Galacs/valrob-carte-actionneurs-cdf-1/valrob-carte-actionneurs-cdf-1.kicad_pcb

## KiCad design valrob-carte-actionneurs-cdf-1.kicad_pcb (2026-04-12)

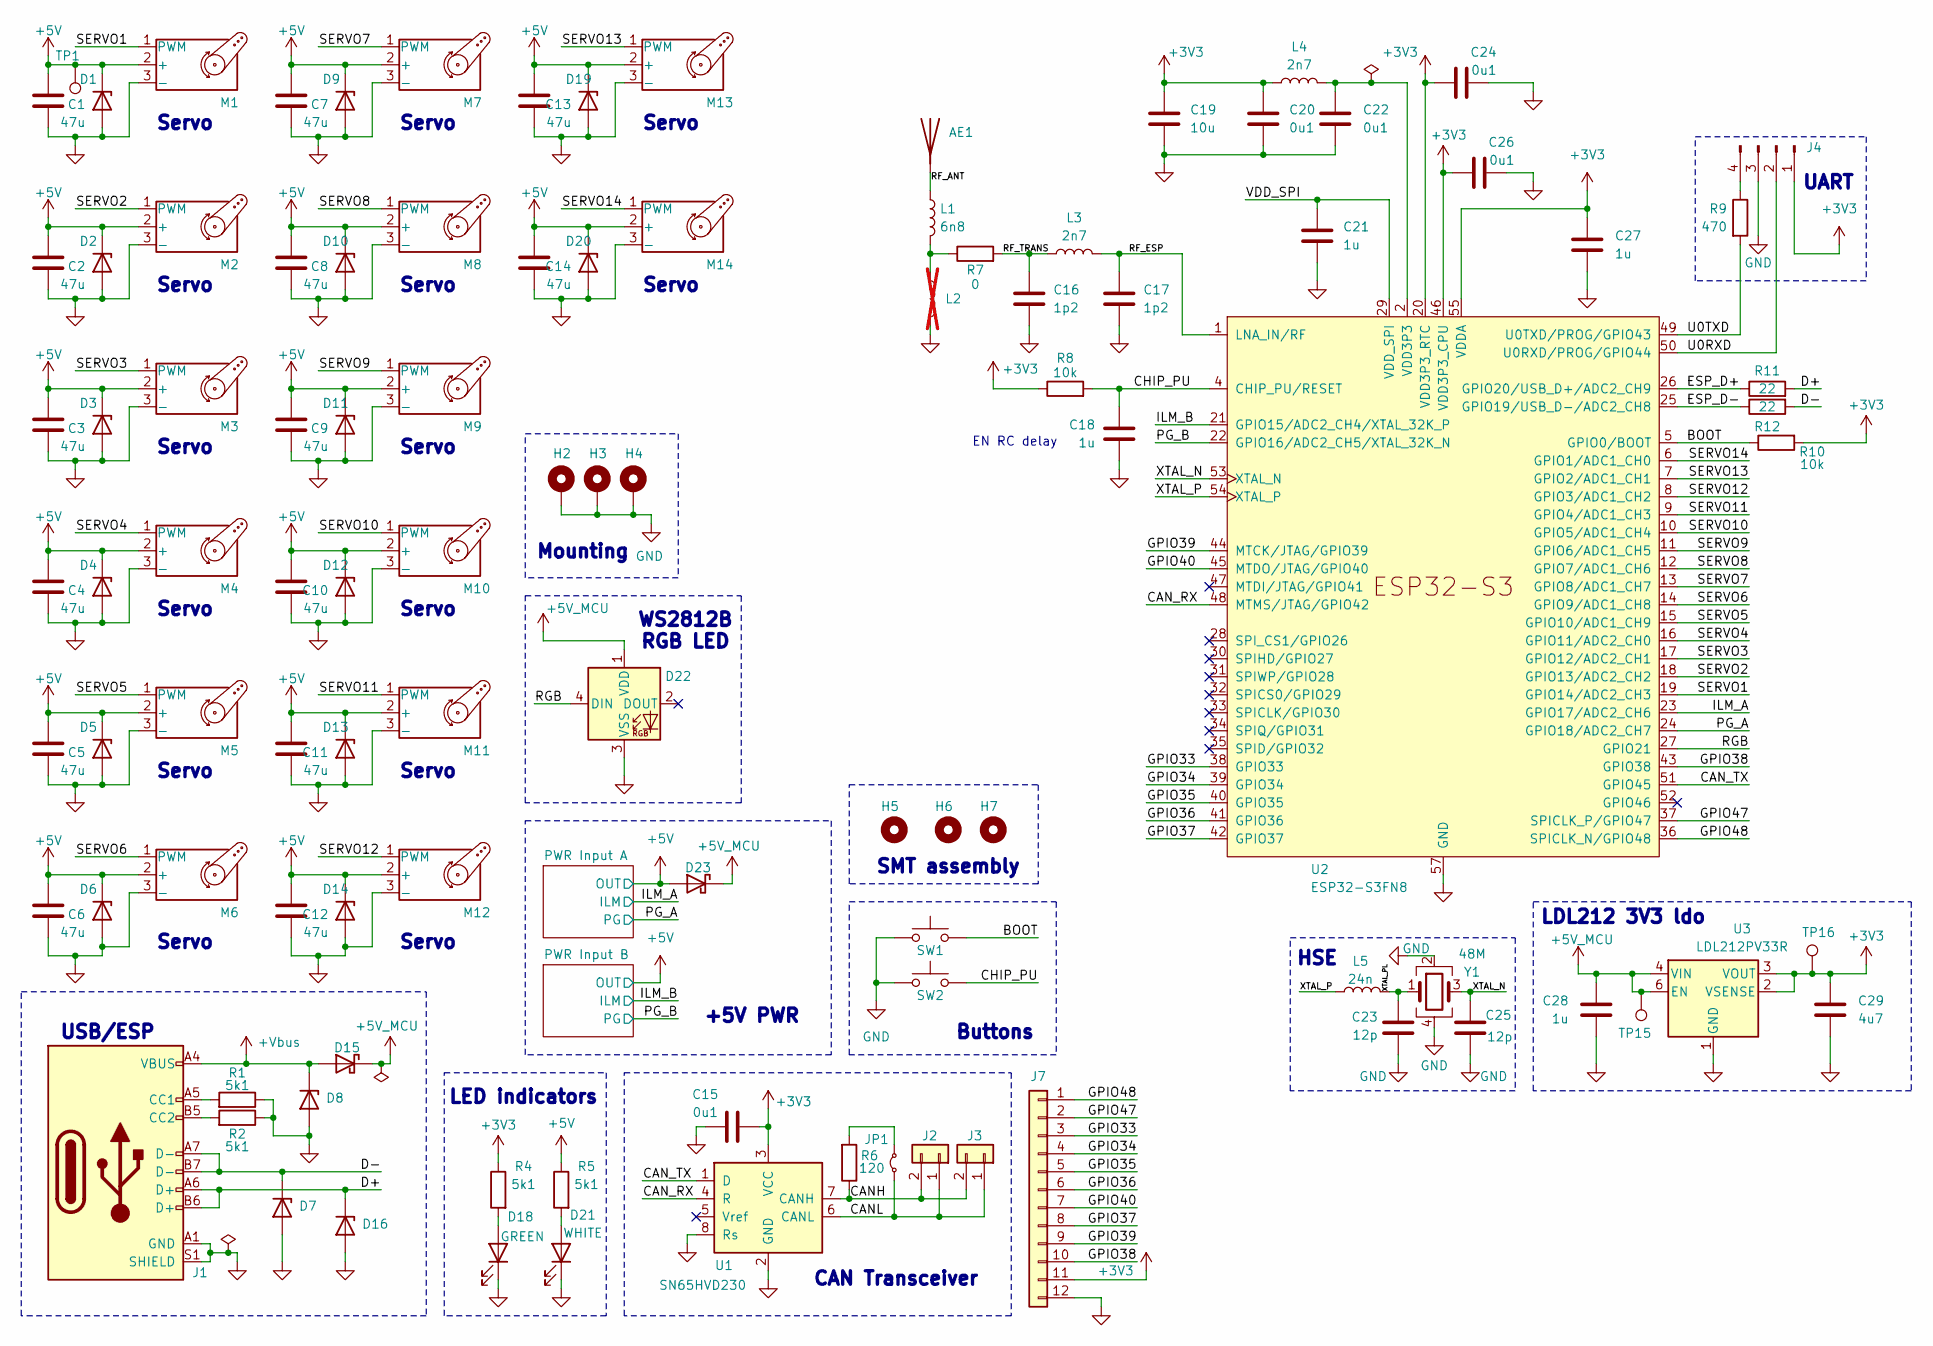
[picture p1: schematic valrob-carte-actionneurs-cdf-1.kicad_sch, Carte actionneurs CDF 1]

Parts:
AE1: Antenna; Johanson_2450AT18x100; Manufacturer Part Number RFANT3216120A5T; JLCPCB Part # C127629
C1, C2, C3, C4, C5, C6, C7, C8, C9, C10, C11, C12, C13, C14: 47u; C_1206_3216Metric; Manufacturer Part Number CL31A476MPHNNNE; JLCPCB Part # C96123
C15, C20, C22, C24, C26: 0u1; C_0402_1005Metric; Manufacturer Part Number CL05B104KB54PNC; JLCPCB Part # C307331
C16, C17: 1p2; C_0402_1005Metric; Manufacturer Part Number GJM1555C1H1R2WB01D; JLCPCB Part # C76899
C18, C21, C27, C28: 1u; C_0402_1005Metric; Manufacturer Part Number CL05A105KA5NQNC; JLCPCB Part # C52923
C19: 10u; C_0402_1005Metric; Manufacturer Part Number CL05A106MQ5NUNC; JLCPCB Part # C15525
C23, C25: 12p; C_0402_1005Metric; Manufacturer Part Number 0402CG120J500NT; JLCPCB Part # C1547
C29: 4u7; C_0402_1005Metric; Manufacturer Part Number CL05A475MP5NRNC; JLCPCB Part # C23733
D1, D2, D3, D4, D5, D6, D7, D8, D9, D10, D11, D12, D13, D14, D16, D19, D20: H5VU10U; Diode_DFN1006; Manufacturer Part Number H5VU10U; JLCPCB Part # C22395519
D15, D23: D_Schottky; D_SMA; Manufacturer Part Number SS54; JLCPCB Part # C22452
D18: GREEN; LED_0805_2012Metric; Manufacturer Part Number KT-0805G; JLCPCB Part # C2297
D21: WHITE; LED_0603_1608Metric; Manufacturer Part Number KT-0603W; JLCPCB Part # C2290
D22: WS2812B; LED_WS2812B_PLCC4_5.0x5.0mm_P3.2mm; Manufacturer Part Number WS2812B-V5/W; JLCPCB Part # C2874885
H2, H3, H4: MountingHole_Pad; MountingHole_2.2mm_M2_Pad_Via
H5, H6, H7: MountingHole; ToolingHole_1.152mm
J1: USB_C_Receptacle_USB2.0_14P; USB_C_Receptacle_HRO_TYPE-C-31-M-12; Manufacturer Part Number TYPE-C16PIN; JLCPCB Part # C393939
J2, J3: Conn_01x02; JST_XH_B2B-XH-A_1x02_P2.50mm_Vertical; Manufacturer Part Number B2B-XH-A(LF)(SN); JLCPCB Part # C158012
J4: Conn_01x04_Pin; PinHeader_1x04_P2.54mm_Vertical
J7: Conn_01x12; PinHeader_2x06_P2.54mm_Vertical
JP1: Jumper_2_Small_Bridged; SolderJumper-2_P1.3mm_Open_RoundedPad1.0x1.5mm
L1: 6n8; L_0402_1005Metric; Manufacturer Part Number LQG15HS6N8J02D; JLCPCB Part # C77110
L2: L; L_0402_1005Metric; not fitted
L3, L4: 2n7; L_0402_1005Metric; Manufacturer Part Number LQG15HS2N7S02D; JLCPCB Part # C77108
L5: 24n; L_0402_1005Metric; Manufacturer Part Number LQW15AN24NG00D; JLCPCB Part # C167472
M1, M2, M3, M4, M5, M6, M7, M8, M9, M10, M11, M12, M13, M14: Motor_Servo; PinHeader_1x03_P2.54mm_Vertical
R1, R2, R4, R5: 5k1; R_0402_1005Metric; Manufacturer Part Number 0402WGF5101TCE; JLCPCB Part # C25905
R6: 120; R_1206_3216Metric; Manufacturer Part Number 1206W4F1200T5E; JLCPCB Part # C17909
R7: 0; R_0402_1005Metric; Manufacturer Part Number 0402WGF0000TCE; JLCPCB Part # C17168
R8, R10: 10k; R_0402_1005Metric; Manufacturer Part Number 0402WGF1002TCE; JLCPCB Part # C25744
R9: 470; R_0402_1005Metric; Manufacturer Part Number 0402WGF4700TCE; JLCPCB Part # C25117
R11, R12: 22; R_0402_1005Metric; Manufacturer Part Number 0402WGF220JTCE; JLCPCB Part # C25092
SW1, SW2: SW_Push; SW_SPST_TS-1088-xR020; Manufacturer Part Number TS-1088-AR02016; JLCPCB Part # C720477
TP1, TP15, TP16: TestPoint; TestPoint_Pad_D2.0mm
U1: SN65HVD230; SOIC-8_3.9x4.9mm_P1.27mm; Manufacturer Part Number SN65HVD230DR; JLCPCB Part # C12084
U2: ESP32-S3FN8; QFN-56-1EP_7x7mm_P0.4mm_EP4x4mm_ThermalVias; Manufacturer Part Number ESP32-S3FH4R2; JLCPCB Part # C3013940
U3: LDL212PV33R; DFN-6-1EP_2x2mm_P0.5mm_ST; Manufacturer Part Number LDL212PV33R; JLCPCB Part # C2969892
Y1: 48M; Crystal_SMD_2016-4Pin_2.0x1.6mm; Manufacturer Part Number R940000096; JLCPCB Part # C7206306

Connections:
+3V3: C15.1, C19.1, C20.1, C24.1, C26.1, C27.1, C29.1, J4.1, J7.11, L4.1, R4.1, R8.1, R10.2, TP16.1 (1_1), U1.3 (VCC), U2.20 (VDD3P3_RTC), U2.46 (VDD3P3_CPU), U2.55 (VDDA), U2.56 (VDDA), U3.2 (VSENSE), U3.3 (VOUT); also elsewhere on the board
+5V: C1.1, C2.1, C3.1, C4.1, C5.1, C6.1, C7.1, C8.1, C9.1, C10.1, C11.1, C12.1, C13.1, C14.1, D1.1 (K), D2.1 (K), D3.1 (K), D4.1 (K), D5.1 (K), D6.1 (K), D9.1 (K), D10.1 (K), D11.1 (K), D12.1 (K), D13.1 (K), D14.1 (K), D19.1 (K), D20.1 (K), D23.2 (A), M1.2 (+), M2.2 (+), M3.2 (+), M4.2 (+), M5.2 (+), M6.2 (+), M7.2 (+), M8.2 (+), M9.2 (+), M10.2 (+), M11.2 (+), M12.2 (+), M13.2 (+), M14.2 (+), R5.1, TP1.1 (1_1); also elsewhere on the board
+5V_MCU: C28.1, D15.1 (K), D22.1 (VDD), D23.1 (K), TP15.1 (1_1), U3.4 (VIN), U3.6 (EN)
+Vbus: D8.1 (K), D15.2 (A), J1.A4 (VBUS), J1.A9 (VBUS), J1.B4 (VBUS), J1.B9 (VBUS)
/BOOT: R10.1, SW1.2, U2.5 (GPIO0/BOOT)
/CANH: J2.2, J3.2, R6.1, U1.7 (CANH)
/CANL: J2.1, J3.1, JP1.1 (A), U1.6 (CANL)
/CAN_RX: U1.4 (R), U2.48 (MTMS/JTAG/GPIO42)
/CAN_TX: U1.1 (D), U2.51 (GPIO45)
/CHIP_PU: C18.1, R8.2, SW2.2, U2.4 (CHIP_PU/RESET)
/D+: D16.1 (K), J1.A6 (D+), J1.B6 (D+), R11.2
/D-: D7.1 (K), J1.A7 (D-), J1.B7 (D-), R12.2
/ESP_D+: R11.1, U2.26 (GPIO20/USB_D+/ADC2_CH9)
/ESP_D-: R12.1, U2.25 (GPIO19/USB_D-/ADC2_CH8)
/GPIO33: J7.3, U2.38 (GPIO33)
/GPIO34: J7.4, U2.39 (GPIO34)
/GPIO35: J7.5, U2.40 (GPIO35)
/GPIO36: J7.6, U2.41 (GPIO36)
/GPIO37: J7.8, U2.42 (GPIO37)
/GPIO38: J7.10, U2.43 (GPIO38)
/GPIO39: J7.9, U2.44 (MTCK/JTAG/GPIO39)
/GPIO40: J7.7, U2.45 (MTDO/JTAG/GPIO40)
/GPIO47: J7.2, U2.37 (SPICLK_P/GPIO47)
/GPIO48: J7.1, U2.36 (SPICLK_N/GPIO48)
/ILM_A: U2.23 (GPIO17/ADC2_CH6); also elsewhere on the board
/ILM_B: U2.21 (GPIO15/ADC2_CH4/XTAL_32K_P); also elsewhere on the board
/PG_A: U2.24 (GPIO18/ADC2_CH7); also elsewhere on the board
/PG_B: U2.22 (GPIO16/ADC2_CH5/XTAL_32K_N); also elsewhere on the board
/RF_ANT: AE1.1 (A_1), L1.1
/RF_ESP: C17.1, L3.2, U2.1 (LNA_IN/RF)
/RF_TRANS: C16.1, L3.1, R7.2
/RGB: D22.4 (DIN), U2.27 (GPIO21)
/SERVO1: M1.1 (PWM), U2.19 (GPIO14/ADC2_CH3)
/SERVO2: M2.1 (PWM), U2.18 (GPIO13/ADC2_CH2)
/SERVO3: M3.1 (PWM), U2.17 (GPIO12/ADC2_CH1)
/SERVO4: M4.1 (PWM), U2.16 (GPIO11/ADC2_CH0)
/SERVO5: M5.1 (PWM), U2.15 (GPIO10/ADC1_CH9)
/SERVO6: M6.1 (PWM), U2.14 (GPIO9/ADC1_CH8)
/SERVO7: M7.1 (PWM), U2.13 (GPIO8/ADC1_CH7)
/SERVO8: M8.1 (PWM), U2.12 (GPIO7/ADC1_CH6)
/SERVO9: M9.1 (PWM), U2.11 (GPIO6/ADC1_CH5)
/SERVO10: M10.1 (PWM), U2.10 (GPIO5/ADC1_CH4)
/SERVO11: M11.1 (PWM), U2.9 (GPIO4/ADC1_CH3)
/SERVO12: M12.1 (PWM), U2.8 (GPIO3/ADC1_CH2)
/SERVO13: M13.1 (PWM), U2.7 (GPIO2/ADC1_CH1)
/SERVO14: M14.1 (PWM), U2.6 (GPIO1/ADC1_CH0)
/U0RXD: J4.2, U2.50 (U0RXD/PROG/GPIO44)
/U0TXD: R9.2, U2.49 (U0TXD/PROG/GPIO43)
/VDD_SPI: C21.1, U2.29 (VDD_SPI)
/XTAL_N: C25.1, U2.53 (XTAL_N), Y1.3
/XTAL_P: L5.1, U2.54 (XTAL_P)
/XTAL_PL: C23.2, L5.2, Y1.1
GND: C1.2, C2.2, C3.2, C4.2, C5.2, C6.2, C7.2, C8.2, C9.2, C10.2, C11.2, C12.2, C13.2, C14.2, C15.2, C16.2, C17.2, C18.2, C19.2, C20.2, C21.2, C22.2, C23.1, C24.2, C25.2, C26.2, C27.2, C28.2, C29.2, D1.2 (A), D2.2 (A), D3.2 (A), D4.2 (A), D5.2 (A), D6.2 (A), D7.2 (A), D8.2 (A), D9.2 (A), D10.2 (A), D11.2 (A), D12.2 (A), D13.2 (A), D14.2 (A), D16.2 (A), D18.1 (K), D19.2 (A), D20.2 (A), D21.1 (K), D22.3 (VSS), H2.1 (1_1), H3.1 (1_1), H4.1 (1_1), J1.A1 (GND), J1.A12 (GND), J1.B1 (GND), J1.B12 (GND), J1.S1 (SHIELD), J4.3, J7.12, L2.2, M1.3 (-), M2.3 (-), M3.3 (-), M4.3 (-), M5.3 (-), M6.3 (-), M7.3 (-), M8.3 (-), M9.3 (-), M10.3 (-), M11.3 (-), M12.3 (-), M13.3 (-), M14.3 (-), R1.1, R2.1, SW1.1, SW2.1, U1.2 (GND), U1.8 (Rs), U2.57 (GND), U3.1 (GND), Y1.2, Y1.4; also elsewhere on the board
unnamed: D18.2 (A), R4.2
unnamed: D21.2 (A), R5.2
unnamed: J1.A5 (CC1), R1.2
unnamed: J1.B5 (CC2), R2.2
unnamed: J4.4, R9.1
unnamed: JP1.2 (B), R6.2
unnamed: L1.2, L2.1, R7.1
VDD3P3: C22.1, L4.2, U2.2 (VDD3P3), U2.3 (VDD3P3)

Notes on the sheet:
WS2812B RGB LED
USB/ESP
Servo
CAN Transceiver
UART
Mounting
LDL212 3V3 ldo
Buttons
SMT assembly
HSE
+5V PWR
LED indicators
EN RC delay

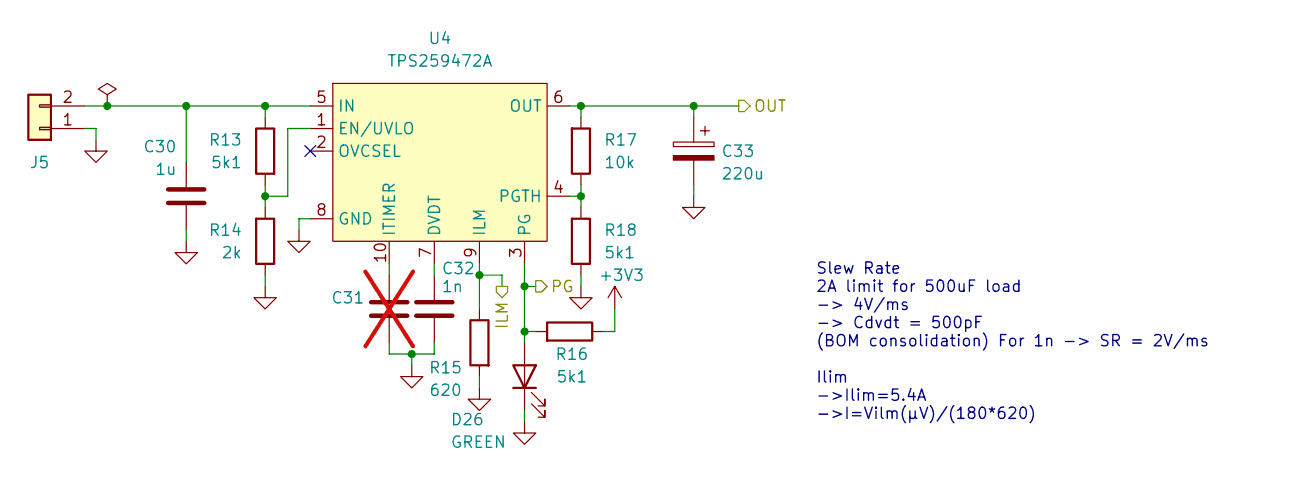
[picture p2: schematic pwr-input.kicad_sch]

Parts:
C30: 1u; C_0402_1005Metric; Manufacturer Part Number CL05A105KA5NQNC; JLCPCB Part # C52923
C31: C; C_0402_1005Metric; not fitted
C32: 1n; C_0402_1005Metric; Manufacturer Part Number 0402B102K500NT; JLCPCB Part # C1523
C33: 220u; CP_Elec_6.3x7.7; Manufacturer Part Number RVT1E221M0607; JLCPCB Part # C2918361
D26: GREEN; LED_0805_2012Metric; Manufacturer Part Number KT-0805G; JLCPCB Part # C2297
J5: Conn_01x02; JST_XH_B2B-XH-A_1x02_P2.50mm_Vertical; Manufacturer Part Number B2B-XH-A(LF)(SN); JLCPCB Part # C158012
R13, R16, R18: 5k1; R_0402_1005Metric; Manufacturer Part Number 0402WGF5101TCE; JLCPCB Part # C25905
R14: 2k; R_0402_1005Metric; Manufacturer Part Number 0402WGF2001TCE; JLCPCB Part # C4109
R15: 620; R_0402_1005Metric; Manufacturer Part Number 0402WGF6200TCE; JLCPCB Part # C4961
R17: 10k; R_0402_1005Metric; Manufacturer Part Number 0402WGF1002TCE; JLCPCB Part # C25744
U4: TPS259472A; Texas_RPW0010A_VQFN-HR-10_2x2mm_P0.5mm; Manufacturer Part Number TPS259472ARPWR; JLCPCB Part # C3662789

Connections:
+3V3: R16.1; also elsewhere on the board
+5V: C33.1, R17.2, U4.6 (OUT); also elsewhere on the board
/ILM_B: R15.1, U4.9 (ILM); also elsewhere on the board
/PG_B: D26.2 (A), R16.2, U4.3 (PG); also elsewhere on the board
GND: C30.1, C31.2, C32.2, C33.2, D26.1 (K), J5.1, R14.1, R15.2, R18.1, U4.8 (GND); also elsewhere on the board
unnamed: C30.2, J5.2, R13.1, U4.5 (IN)
unnamed: C32.1, U4.7 (DVDT)
unnamed: R13.2, R14.2, U4.1 (EN/UVLO)
unnamed: C31.1, U4.10 (ITIMER)
unnamed: R17.1, R18.2, U4.4 (PGTH)

Parts of its further copies:
C35: 1u; C_0402_1005Metric; Manufacturer Part Number CL05A105KA5NQNC; JLCPCB Part # C52923
C36: C; C_0402_1005Metric; not fitted
C37: 1n; C_0402_1005Metric; Manufacturer Part Number 0402B102K500NT; JLCPCB Part # C1523
C38: 220u; CP_Elec_6.3x7.7; Manufacturer Part Number RVT1E221M0607; JLCPCB Part # C2918361
D27: GREEN; LED_0805_2012Metric; Manufacturer Part Number KT-0805G; JLCPCB Part # C2297
J6: Conn_01x02; JST_XH_B2B-XH-A_1x02_P2.50mm_Vertical; Manufacturer Part Number B2B-XH-A(LF)(SN); JLCPCB Part # C158012
R19, R22, R24: 5k1; R_0402_1005Metric; Manufacturer Part Number 0402WGF5101TCE; JLCPCB Part # C25905
R20: 2k; R_0402_1005Metric; Manufacturer Part Number 0402WGF2001TCE; JLCPCB Part # C4109
R21: 620; R_0402_1005Metric; Manufacturer Part Number 0402WGF6200TCE; JLCPCB Part # C4961
R23: 10k; R_0402_1005Metric; Manufacturer Part Number 0402WGF1002TCE; JLCPCB Part # C25744
U5: TPS259472A; Texas_RPW0010A_VQFN-HR-10_2x2mm_P0.5mm; Manufacturer Part Number TPS259472ARPWR; JLCPCB Part # C3662789

Connections of its further copies:
+3V3: R22.1; also elsewhere on the board
+5V: C38.1, R23.2, U5.6 (OUT); also elsewhere on the board
/ILM_A: R21.1, U5.9 (ILM); also elsewhere on the board
/PG_A: D27.2 (A), R22.2, U5.3 (PG); also elsewhere on the board
GND: C35.1, C36.2, C37.2, C38.2, D27.1 (K), J6.1, R20.1, R21.2, R24.1, U5.8 (GND); also elsewhere on the board
unnamed: C35.2, J6.2, R19.1, U5.5 (IN)
unnamed: C37.1, U5.7 (DVDT)
unnamed: R19.2, R20.2, U5.1 (EN/UVLO)
unnamed: C36.1, U5.10 (ITIMER)
unnamed: R23.1, R24.2, U5.4 (PGTH)

Notes on the sheet:
Slew Rate 2A limit for 500uF load -> 4V/ms -> Cdvdt = 500pF (BOM consolidation) For 1n -> SR = 2V/ms Ilim ->Ilim=5.4A ->I=Vilm(µV)/(180*620)

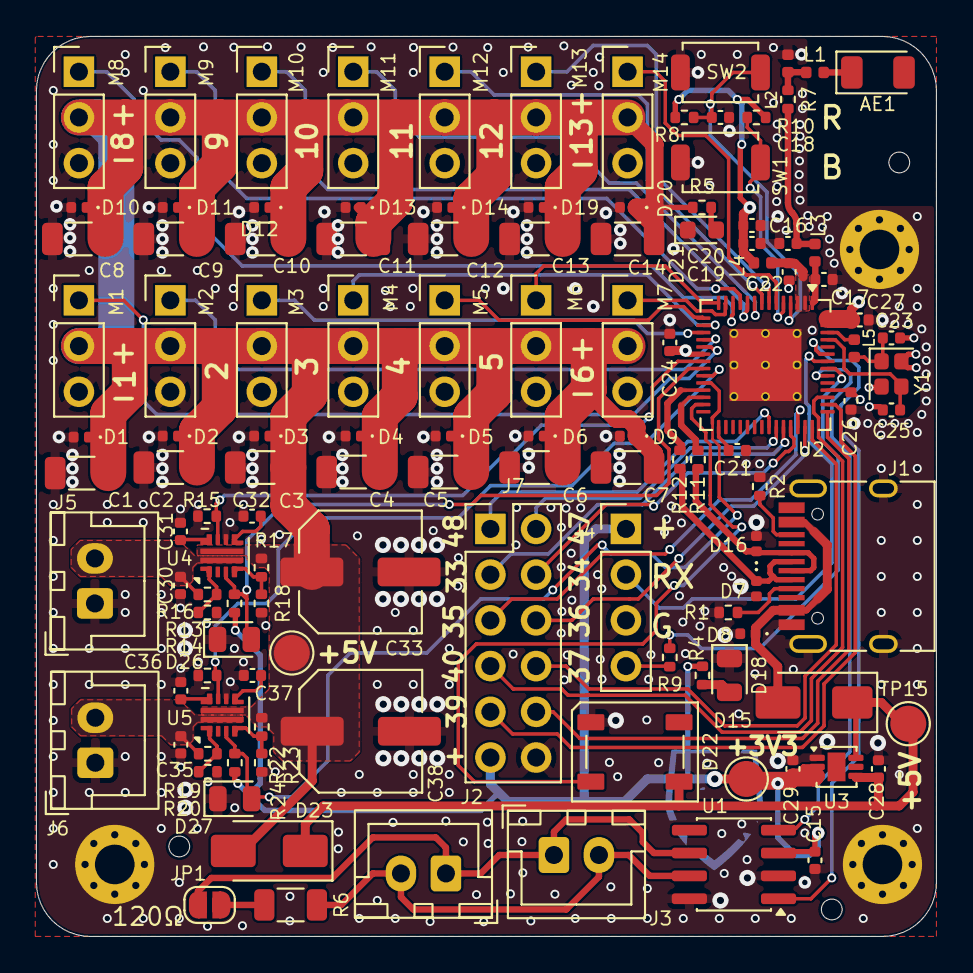
[picture p3: board valrob-carte-actionneurs-cdf-1.kicad_pcb from above]

Board: 4 copper layers, 50.0 x 50.0 mm, 129 parts (0 on the bottom side), 71 nets.
