Galacs/valrob-carte-actionneurs-cdf-1/(commit log)

2026-02-17 schem: import esp32s3 from valrob-pami
    [valrob-carte-actionneurs-cdf-1.kicad_sch]
2026-02-17 schem: import esp32 HSE crystal
    [valrob-carte-actionneurs-cdf-1.kicad_sch]
2026-02-17 schem: add USB c connector
    [valrob-carte-actionneurs-cdf-1.kicad_sch]
2026-02-17 schem: add servo connector
    [valrob-carte-actionneurs-cdf-1.kicad_sch]
2026-02-17 schem: add led indicators
    [valrob-carte-actionneurs-cdf-1.kicad_sch]
2026-02-17 schem: import LDL212 3V3 ldo
    [valrob-carte-actionneurs-cdf-1.kicad_sch]
2026-02-17 schem: add TPS259472A 5v power input efuse
    [connectors.kicad_sch, valrob-carte-actionneurs-cdf-1.kicad_sch]
2026-02-17 schem: update efuse to work as downstream
    [connectors.kicad_sch]
2026-02-17 schem: configure efuse
    [connectors.kicad_sch, valrob-carte-actionneurs-cdf-1.kicad_sch]
2026-02-18 schem: add dual 5v pwr inputs
    [pwr-input.kicad_sch, valrob-carte-actionneurs-cdf-1.kicad_sch]
2026-02-18 schem: add status rgb leds
    [valrob-carte-actionneurs-cdf-1.kicad_sch]
2026-02-18 schem: add dual port can transceiver
    [valrob-carte-actionneurs-cdf-1.kicad_sch]
2026-02-18 schem: add 5v rail status leds
    [valrob-carte-actionneurs-cdf-1.kicad_sch]
2026-02-18 schem: reorganize
    [valrob-carte-actionneurs-cdf-1.kicad_sch]
2026-02-18 schem: connect peripherals gpios
    [valrob-carte-actionneurs-cdf-1.kicad_sch]
2026-02-18 schem: add CHIP_PU and BOOT buttons
    [valrob-carte-actionneurs-cdf-1.kicad_sch]
2026-02-18 schem: add test points
    [valrob-carte-actionneurs-cdf-1.kicad_sch]
2026-02-18 schem: add 14 servo channels
    [valrob-carte-actionneurs-cdf-1.kicad_sch]
2026-02-18 schem: run and fix ERC
    [pwr-input.kicad_sch, valrob-carte-actionneurs-cdf-1.kicad_sch]
2026-02-18 schem: fix BOM
    [valrob-carte-actionneurs-cdf-1.kicad_sch]
2026-02-18 schem: add sheet title
    [valrob-carte-actionneurs-cdf-1.kicad_sch]
2026-02-18 schem: reannotate
    [pwr-input.kicad_sch, valrob-carte-actionneurs-cdf-1.kicad_sch]
2026-02-18 pcb: import pcb stackup and constraints
    [valrob-carte-actionneurs-cdf-1.kicad_pcb]
2026-02-18 pcb: import footprints from schem
    [valrob-carte-actionneurs-cdf-1.kicad_pcb]
2026-02-18 pcb: import missing 3d models
    [valrob-carte-actionneurs-cdf-1.kicad_pcb]
2026-02-18 schem/pcb: use TPS efuses ORing configuration
    [valrob-carte-actionneurs-cdf-1.kicad_pcb, valrob-carte-actionneurs-cdf-1.kicad_sch]
2026-02-18 schem: remove 5v input bulk cap
    [valrob-carte-actionneurs-cdf-1.kicad_pcb]
2026-02-18 pcb: add 2x TPS25947 layout
    [pwr-input.kicad_sch, valrob-carte-actionneurs-cdf-1.kicad_pcb]
2026-02-18 pcb: add USB C initial layout
    [valrob-carte-actionneurs-cdf-1.kicad_pcb]
2026-02-18 pcb: add LDL212 3V3 ldo initial layout
    [valrob-carte-actionneurs-cdf-1.kicad_pcb]
2026-02-18 schem: remove extra test points
    [valrob-carte-actionneurs-cdf-1.kicad_sch]
2026-02-18 schem: add servo components classes
    [valrob-carte-actionneurs-cdf-1.kicad_sch]
2026-02-18 pcb: initial servo routing
    [valrob-carte-actionneurs-cdf-1.kicad_pcb, valrob-carte-actionneurs-cdf-1.kicad_sch]
2026-02-19 schem: add servo initial layout
    [valrob-carte-actionneurs-cdf-1.kicad_pcb, valrob-carte-actionneurs-cdf-1.kicad_sch]
2026-02-19 pcb: add initial layout
    [valrob-carte-actionneurs-cdf-1.kicad_pcb, valrob-carte-actionneurs-cdf-1.kicad_sch]
2026-02-20 schem: remove one rgb led
    [valrob-carte-actionneurs-cdf-1.kicad_sch]
2026-02-20 schem: remove extra power indicator led
    [valrob-carte-actionneurs-cdf-1.kicad_sch]
2026-02-20 pcb: add board outline
    [valrob-carte-actionneurs-cdf-1.kicad_pcb]
2026-02-20 schem: add mounting holes
    [valrob-carte-actionneurs-cdf-1.kicad_sch]
2026-02-20 pcb: add initial component placement
    [valrob-carte-actionneurs-cdf-1.kicad_pcb, valrob-carte-actionneurs-cdf-1.kicad_sch]
2026-02-20 schem: add extra GPIOs header
    [valrob-carte-actionneurs-cdf-1.kicad_sch]
2026-02-20 pcb: add gpio header
    [valrob-carte-actionneurs-cdf-1.kicad_pcb]
2026-02-21 pcb: line up gpio to 2.54 grid
    [valrob-carte-actionneurs-cdf-1.kicad_pcb]
2026-02-21 pcb: layout refinement
    [valrob-carte-actionneurs-cdf-1.kicad_pcb]
2026-02-21 pcb: add gnd planes
    [valrob-carte-actionneurs-cdf-1.kicad_pcb]
2026-02-21 pcb: add gnd vias
    [valrob-carte-actionneurs-cdf-1.kicad_pcb]
2026-02-21 pcb: add drill/place origin
    [valrob-carte-actionneurs-cdf-1.kicad_pcb]
2026-02-21 schem: reorganize programmable GPIOs
    [valrob-carte-actionneurs-cdf-1.kicad_pcb, valrob-carte-actionneurs-cdf-1.kicad_sch]
2026-02-21 pcb: add rf routing
    [valrob-carte-actionneurs-cdf-1.kicad_pcb]
2026-02-21 pcb: add crystal routing
    [valrob-carte-actionneurs-cdf-1.kicad_pcb]
2026-02-21 pcb: add usb routing
    [valrob-carte-actionneurs-cdf-1.kicad_pcb]
2026-02-21 pcb: add can routing
    [valrob-carte-actionneurs-cdf-1.kicad_pcb]
2026-02-21 pcb: add UART routing
    [valrob-carte-actionneurs-cdf-1.kicad_pcb]
2026-02-21 pcb: add servo 5V routing
    [valrob-carte-actionneurs-cdf-1.kicad_pcb]
2026-02-21 pcb: add efuse and 5v pwr routing
    [valrob-carte-actionneurs-cdf-1.kicad_pcb]
2026-02-21 pcb: add servo PWM routing
    [valrob-carte-actionneurs-cdf-1.kicad_pcb, valrob-carte-actionneurs-cdf-1.kicad_sch]
2026-02-21 pcb: add usb c routing
    [valrob-carte-actionneurs-cdf-1.kicad_pcb]
2026-02-21 pcb: add BOOT and CHIP_PU routing
    [valrob-carte-actionneurs-cdf-1.kicad_pcb]
2026-02-21 pcb: add spare GPIOs routing
    [valrob-carte-actionneurs-cdf-1.kicad_pcb, valrob-carte-actionneurs-cdf-1.kicad_sch]
2026-02-21 pcb: add efuse mcu routing
    [valrob-carte-actionneurs-cdf-1.kicad_pcb, valrob-carte-actionneurs-cdf-1.kicad_sch]
2026-02-21 pcb: add RGB led routing
    [valrob-carte-actionneurs-cdf-1.kicad_pcb]
2026-02-21 pcb: add 3v3 pwr routing
    [valrob-carte-actionneurs-cdf-1.kicad_pcb]
2026-02-21 pcb: add stitching vias
    [valrob-carte-actionneurs-cdf-1.kicad_pcb]
2026-02-21 pcb: run and fix DRC
    [valrob-carte-actionneurs-cdf-1.kicad_pcb]
2026-02-21 pcb: remove unused internal pads
    [valrob-carte-actionneurs-cdf-1.kicad_pcb]
2026-02-21 pcb: clean up silkscreen
    [valrob-carte-actionneurs-cdf-1.kicad_pcb]
2026-02-21 pcb: add user txt
    [valrob-carte-actionneurs-cdf-1.kicad_pcb]
2026-02-21 generate production files
    [bom.csv, designators.csv, positions.csv, valrob-carte-actionneurs-cdf-1.kicad_pcb]
2026-02-23 add jlcjlc placeholder and regenerate production files
    [valrob-carte-actionneurs-cdf-1.kicad_pcb]
2026-03-10 pcb: add title
    [valrob-carte-actionneurs-cdf-1.kicad_pcb]
2026-03-10 pcb: add step export settings
2026-04-12 schem/pcb: update to kicad 10
    [pwr-input.kicad_sch, valrob-carte-actionneurs-cdf-1.kicad_sch]
2026-04-12 schem/pcb: add smt tooling holes
    [valrob-carte-actionneurs-cdf-1.kicad_pcb, valrob-carte-actionneurs-cdf-1.kicad_sch]
2026-04-12 regenerate production files
    [designators.csv, positions.csv, valrob-carte-actionneurs-cdf-1.kicad_pcb]
